TTreeNew/model_for_panda_arm/image2.0/截图 2026-10-16 11-13-02.png

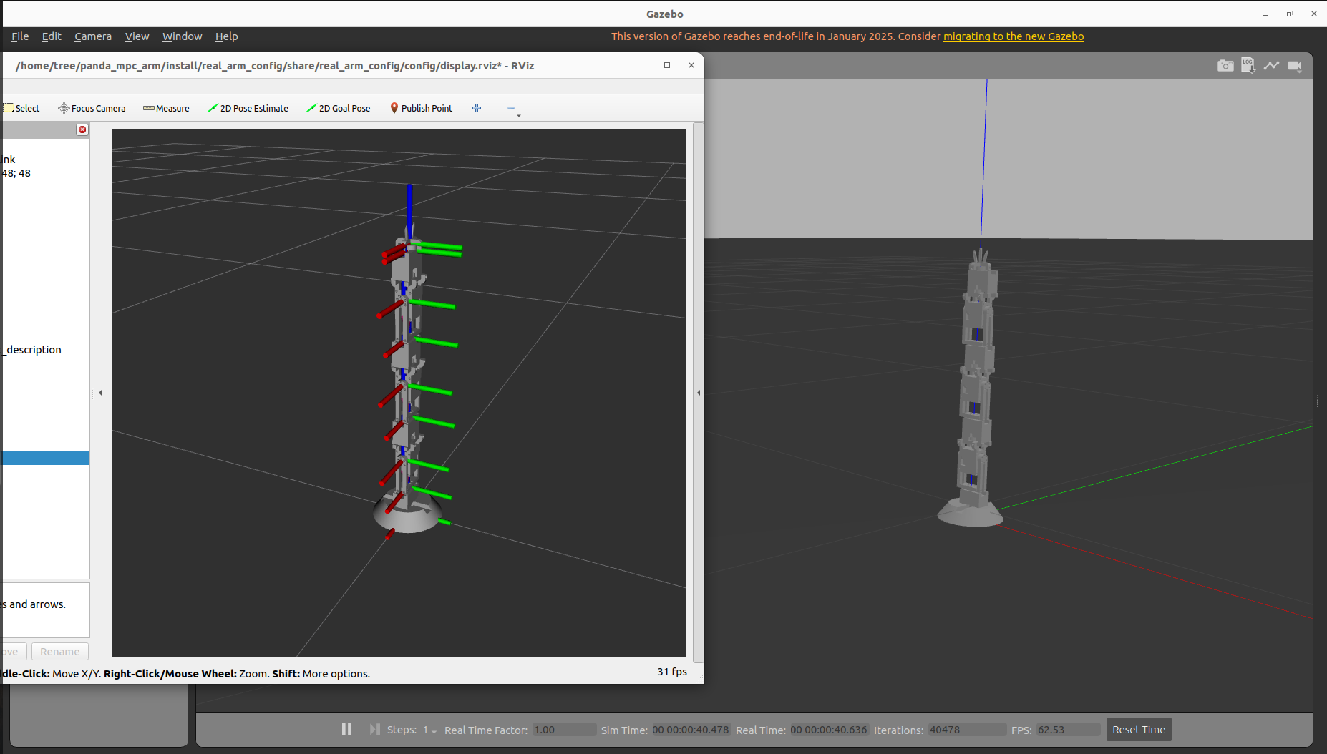
image2.0/截图 2026-10-16 11-13-02.png
