TTreeNew/model_for_panda_arm/model/机械臂部件重量清单.xlsx

部件 | 质量(g)（带一根导线） | 体积(mm^3) | 等效密度(g/mm^3)
base_link | 43.569 | 36587.50439 | 0.001190816393
link_1 | 77.534 | 62498.28592 | 0.001240578023
link_2 | 69.821 | 56574.19778 | 0.001234149184
link_3 | 77.455 | 62136.91821 | 0.001246521428
link_4 | 68.303 | 56640.00416 | 0.001205914459
link_5 | 76.883 | 62498.2772 | 0.001230161909
link_6 | 69.281 | 56490.37909 | 0.001226421226
end_link | 15.754 | 14127.69895 | 0.001115114362
finger | 9.063 | 7427.821017 | 0.001220142486
电机 | 39.048 | 15311.12824 | 0.002550301937
一根线 | 3.363
M1圆柱销 | 0.52
M4长螺丝 | 2.662
M4短螺丝 | 3.493
M2螺丝 | 0.264
保留6位：0.001190 0.001240 0.001234 0.001246 0.001205 0.001230 0.001226 0.001115 0.001220
零件 | 价格(人民币，元)
宇树J288数字无刷电机x7 | 599元/个
配套的总线串口转USB转接板 | 99元/个
petg材料打印外壳 | 共240元
M1.9*12圆柱销钉 x 14 | 12.61元/100个
M4*45尖尾自攻螺丝 x 14 | 2.15元/20个
M4*20平尾螺丝x7 | 忘了
M2*12 平尾机牙螺丝 x 28 | 3.33元/100个
普通螺丝刀 | 忘了
镊子 | 忘了
2.0x150mm超长一字螺丝刀 | 11.8元/个
开关电源（24V，20.8A） | 117.77元/个
开关电源线（1.5米、三插线） | 9.5元/个
电源线U型头x5 | 1.5元/10个
共 4690.66 元
