TTreeNew/model_for_panda_arm/model/panda_arm_back.step

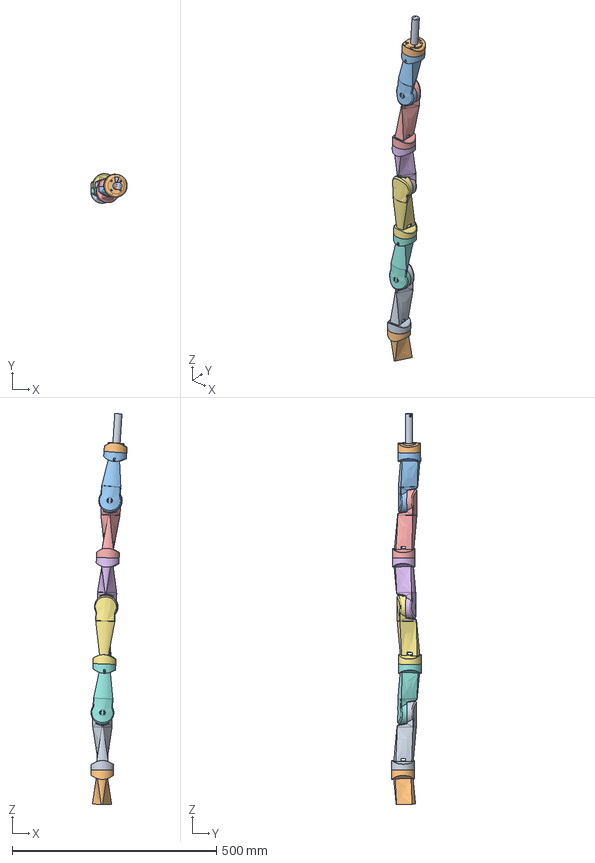
[picture p6: CAD file, 2026-09-03]
model/panda_arm_back.step
89.2 x 72.7 x 957.4 mm
