TTreeNew/model_for_panda_arm/panda_arm_description/meshes/link_5_1.stl

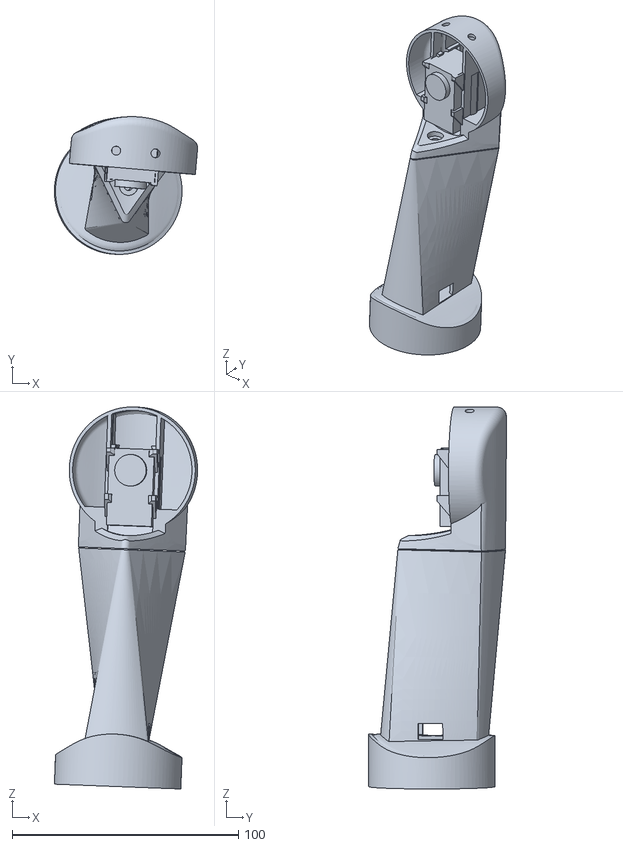
[picture p7: CAD file, 2026-09-03]
panda_arm_description/meshes/link_5_1.stl
63.4 x 60.9 x 169.0
