TTreeNew/model_for_panda_arm/panda_arm_description/meshes/link_3_1.stl

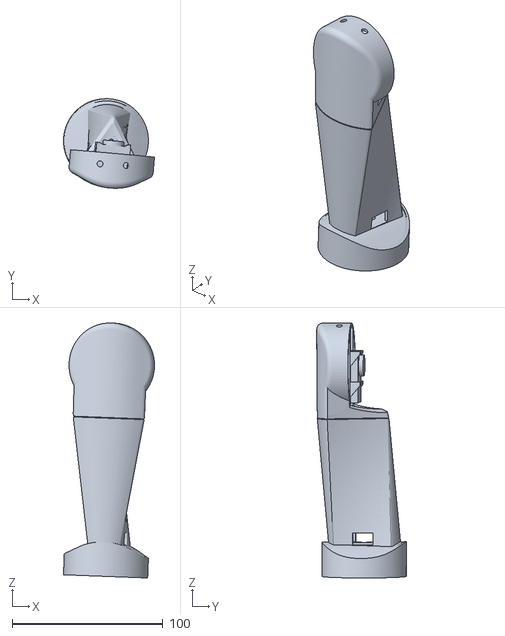
[picture p8: CAD file, 2026-09-03]
panda_arm_description/meshes/link_3_1.stl
60.5 x 59.5 x 169.4
