TTreeNew/model_for_panda_arm/panda_arm_description/meshes/finger_1.stl

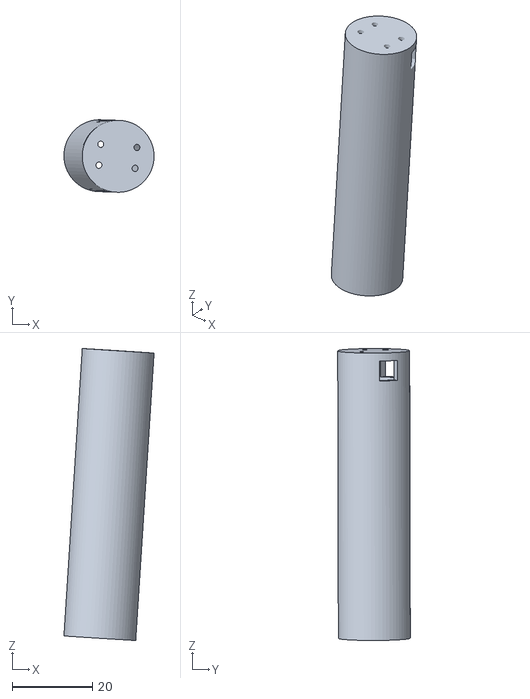
[picture p9: CAD file, 2026-09-03]
panda_arm_description/meshes/finger_1.stl
22.5 x 18.2 x 73.0
