TTreeNew/model_for_panda_arm/panda_arm_description/meshes/link_6_1.stl

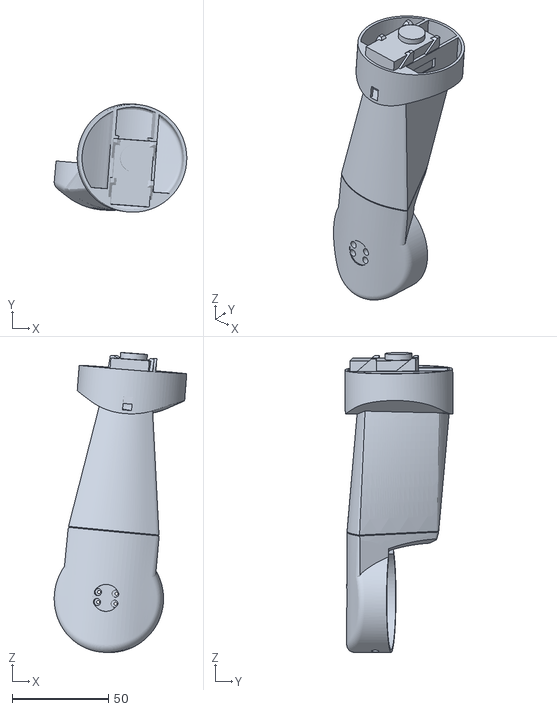
[picture p10: CAD file, 2026-09-03]
panda_arm_description/meshes/link_6_1.stl
68.8 x 56.2 x 155.6
