TTreeNew/model_for_panda_arm/panda_arm_description/meshes/link_4_1.stl

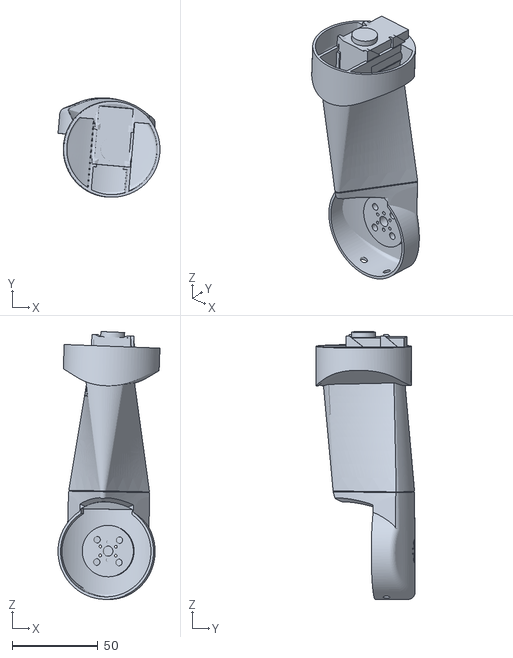
[picture p11: CAD file, 2026-09-03]
panda_arm_description/meshes/link_4_1.stl
59.6 x 58.1 x 156.5
