TTreeNew/model_for_panda_arm/panda_arm_description/meshes/base_link.stl

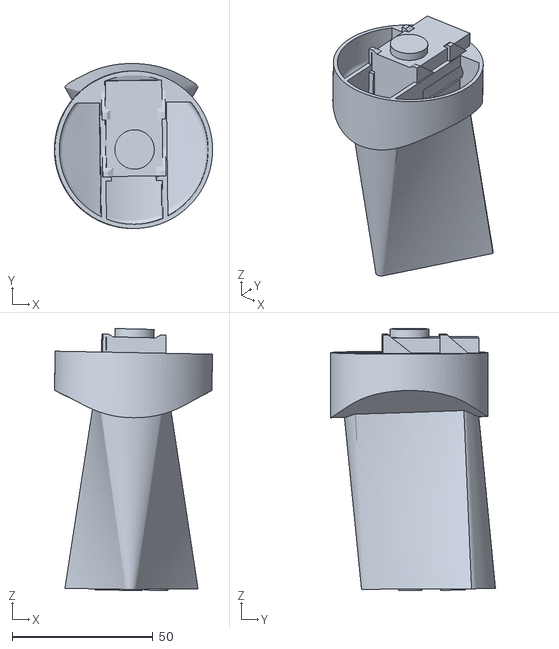
[picture p12: CAD file, 2026-09-03]
panda_arm_description/meshes/base_link.stl
56.2 x 58.7 x 93.2
