TTreeNew/model_for_panda_arm/panda_arm_description/meshes/end_link_1.stl

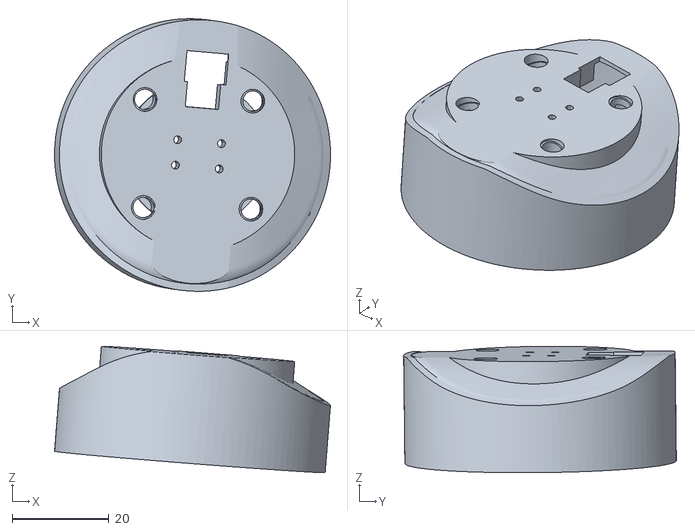
[picture p13: CAD file, 2026-09-03]
panda_arm_description/meshes/end_link_1.stl
56.9 x 56.2 x 26.1
