TTreeNew/model_for_panda_arm/panda_arm_description/meshes/link_1_1.stl

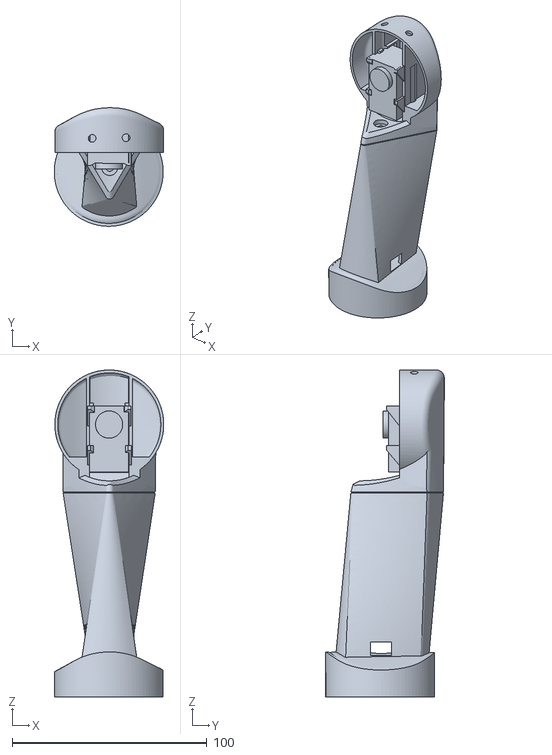
[picture p14: CAD file, 2026-09-03]
panda_arm_description/meshes/link_1_1.stl
56.3 x 61.0 x 168.1
