TTreeNew/model_for_panda_arm/panda_arm_description/meshes/link_2_1.stl

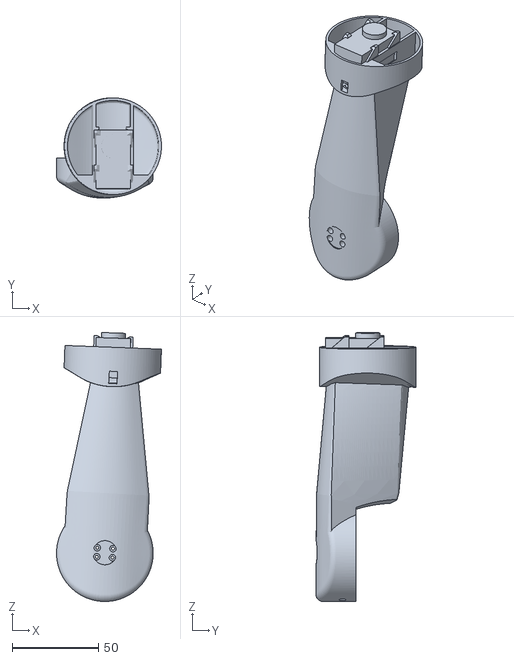
[picture p15: CAD file, 2026-09-03]
panda_arm_description/meshes/link_2_1.stl
60.8 x 58.1 x 155.8
