TTreeNew/model_for_panda_arm/(list of files, cad)

Other CAD files:
model/panda_arm_back.f3d
