TTreeNew/model_for_panda_arm/(commit log)

2026-09-03 桌面机械臂模型和材料清单
    [base_link.stl, end_link_1.stl, finger_1.stl, link_1_1.stl, link_2_1.stl, link_3_1.stl, link_4_1.stl, link_5_1.stl]
2026-09-03 提交.gitignore文件
2026-09-03 补充了开源协议
2026-09-03 补充材料清单
    [机械臂部件重量清单.xlsx]
2026-10-16 将要更新模型，占位
2026-10-16 补充示例项目地址
